andrewsampson/USBTinyISP-Single-Sided-kicad/usbtinyisp-kicad.sch

## KiCad design usbtinyisp-kicad.sch (2012-11-04)

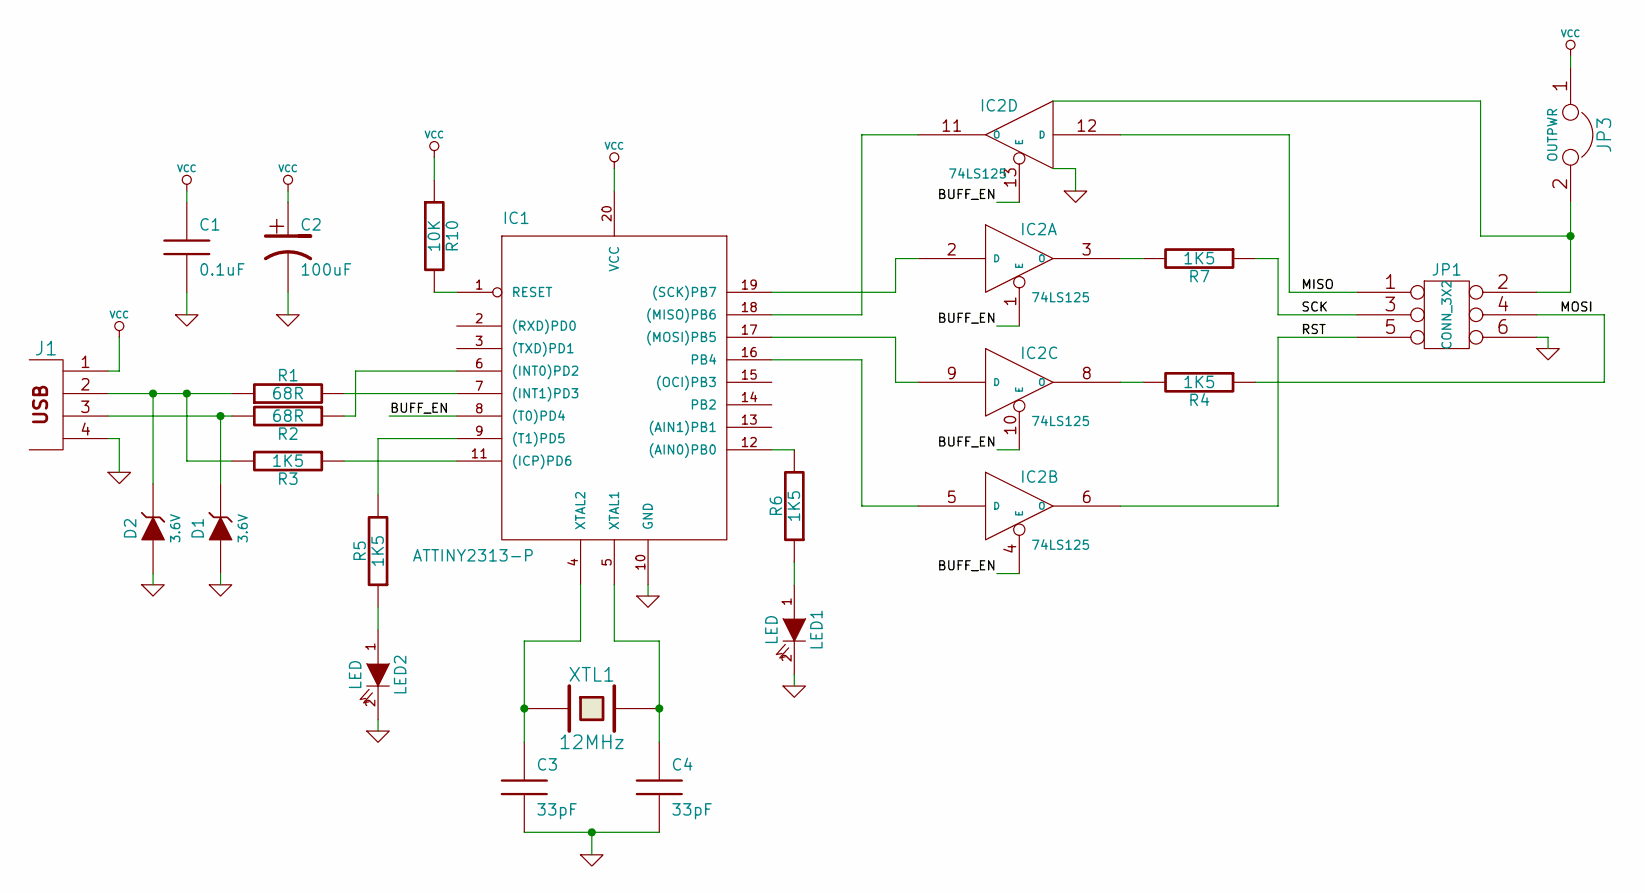
[picture p1: schematic usbtinyisp-kicad.sch]

Parts:
C1: 0.1uF
C2: 100uF
C3, C4: 33pF
D1, D2: 3.6V
IC1: ATTINY2313-P; DIL20
IC2: 74LS125
J1: USB_2; VCC
JP1: CONN_3X2
JP3: OUTPWR
LED1, LED2: LED
R1, R2: 68R
R3, R4, R5, R6, R7: 1K5
R10: 10K
XTL1: 12MHz

Connections:
BUFF_EN: IC1.8 ((T0)PD4), IC2.1 (E), IC2.4 (E), IC2.10 (E), IC2.13 (E)
GND: C1.2, C2.2, C3.2, C4.2, D1.1 (A), D2.1 (A), IC1.10 (GND), IC2.7 (GND), J1.4, JP1.6, LED1.2 (K), LED2.2 (K)
MISO: IC2.12 (D), JP1.1
MOSI: JP1.4, R4.1
unnamed: C3.1, IC1.4 (XTAL2), XTL1.1
unnamed: C4.1, IC1.5 (XTAL1), XTL1.2
unnamed: D1.2 (K), J1.3, R2.2
unnamed: D2.2 (K), J1.2, R1.1, R3.2
unnamed: IC1.1 (RESET), R10.2
unnamed: IC1.6 ((INT0)PD2), R2.1
unnamed: IC1.7 ((INT1)PD3), R1.2
unnamed: IC1.9 ((T1)PD5), R5.2
unnamed: IC1.11 ((ICP)PD6), R3.1
unnamed: IC1.12 ((AIN0)PB0), R6.2
unnamed: IC1.16 (PB4), IC2.5 (D)
unnamed: IC1.17 ((MOSI)PB5), IC2.9 (D)
unnamed: IC1.18 ((MISO)PB6), IC2.11 (O)
unnamed: IC1.19 ((SCK)PB7), IC2.2 (D)
unnamed: IC2.3 (O), R7.2
unnamed: IC2.8 (O), R4.2
unnamed: IC2.14 (VCC), JP1.2, JP3.2
unnamed: LED1.1 (A), R6.1
unnamed: LED2.1 (A), R5.1
RST: IC2.6 (O), JP1.5
SCK: JP1.3, R7.1
VCC: C1.1, C2.1, IC1.20 (VCC), J1.1, JP3.1, R10.1
