andrewsampson/USBTinyISP-Single-Sided-kicad/(commit log)

2012-11-04 Initial import of usbtinyisp-kicad project
    [usbtinyisp-kicad.brd, usbtinyisp-kicad.sch]
2012-11-05 Fixed ground line near zener diodes on usbtinyisp board
    [usbtinyisp-kicad.brd]
2012-11-05 Added script to invoke pcb2gcode w/ proper arguments
2013-02-03 Removed the extra cutting pass argument from the pcb2gcode script
2013-02-03 Added gerber and drill files, so that people don't need to install kicad if they're only interested in milling/etching a board. There are no guarantees that these files will be kept up-to-date.
    [usbtinyisp-kicad-Back.gbl, usbtinyisp-kicad.drl]
2013-02-19 Added bill-of-materials
